lasindu-wick/Vision-Based-Ball-Balancing-PID-System-using-a-Three-DoF-Parallel-Manipulator-Mechanism/Mechanical Design/20230403_133622-removebg-preview.png

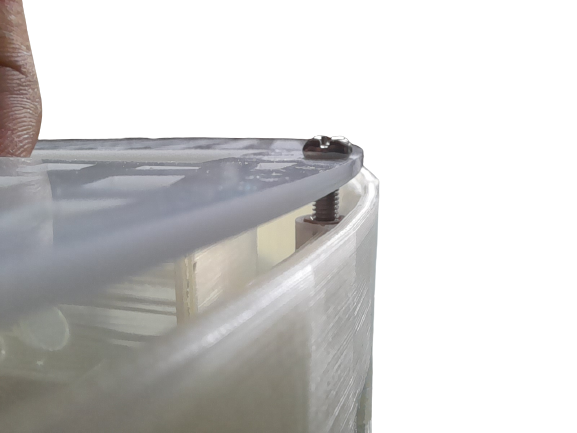
Mechanical Design/20230403_133622-removebg-preview.png
