lasindu-wick/Vision-Based-Ball-Balancing-PID-System-using-a-Three-DoF-Parallel-Manipulator-Mechanism/Mechanical Design/20230403_150713.jpg

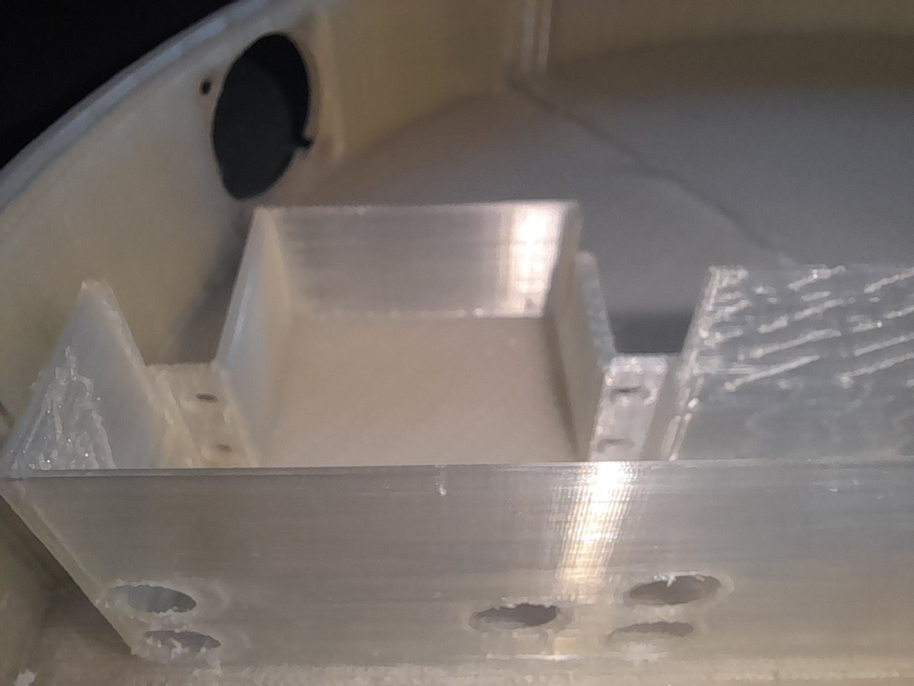
Mechanical Design/20230403_150713.jpg
