lasindu-wick/Vision-Based-Ball-Balancing-PID-System-using-a-Three-DoF-Parallel-Manipulator-Mechanism/Circuit Diagram/Circuit Diagram.jpeg

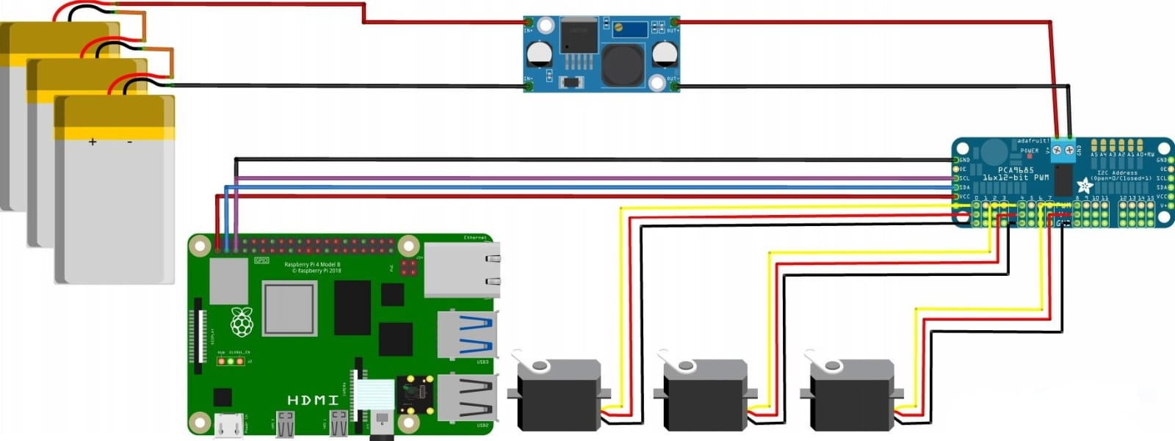
Circuit Diagram/Circuit Diagram.jpeg
