lasindu-wick/Vision-Based-Ball-Balancing-PID-System-using-a-Three-DoF-Parallel-Manipulator-Mechanism/Design Inspirations/2 DoF 2D.png

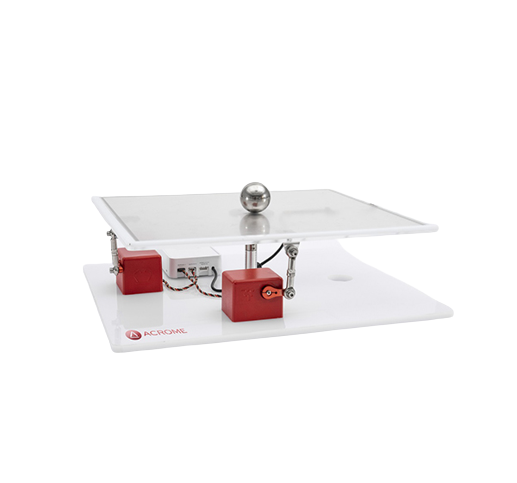
Design Inspirations/2 DoF 2D.png
