lasindu-wick/Vision-Based-Ball-Balancing-PID-System-using-a-Three-DoF-Parallel-Manipulator-Mechanism/Design Inspirations/Initial Conceptual Design.png

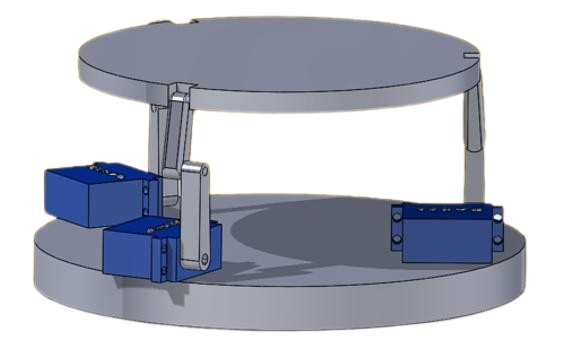
Design Inspirations/Initial Conceptual Design.png
