lasindu-wick/Vision-Based-Ball-Balancing-PID-System-using-a-Three-DoF-Parallel-Manipulator-Mechanism/Mechanical Design/10mm Spacer.png

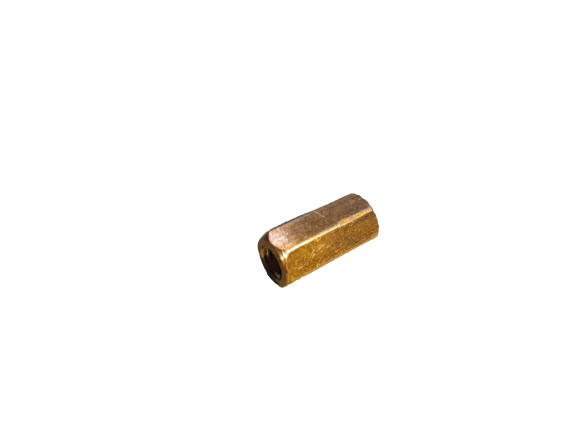
Mechanical Design/10mm Spacer.png
