lasindu-wick/Vision-Based-Ball-Balancing-PID-System-using-a-Three-DoF-Parallel-Manipulator-Mechanism/Mechanical Design/Ball & Socket Joint.png

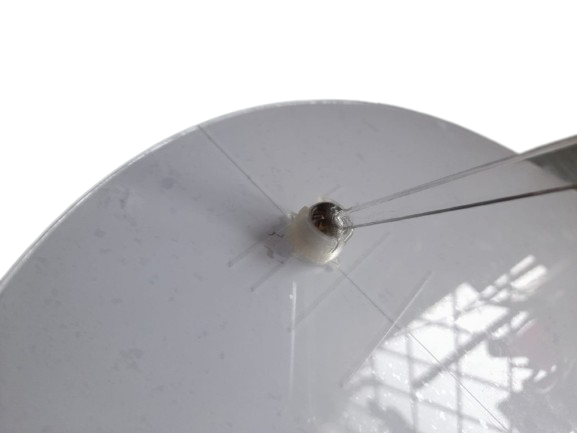
Mechanical Design/Ball & Socket Joint.png
