lasindu-wick/Vision-Based-Ball-Balancing-PID-System-using-a-Three-DoF-Parallel-Manipulator-Mechanism/Mechanical Design/Ball Balancing PID System.png

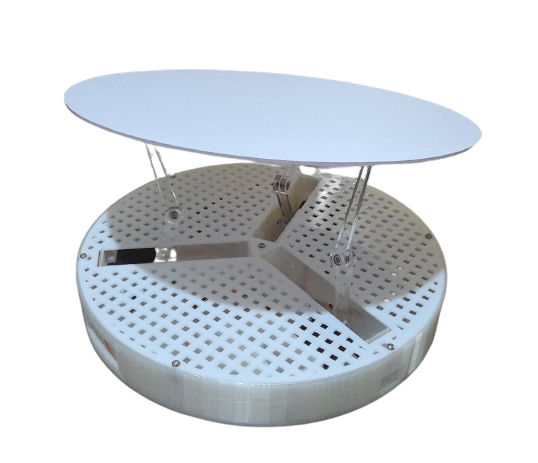
Mechanical Design/Ball Balancing PID System.png
