lasindu-wick/Vision-Based-Ball-Balancing-PID-System-using-a-Three-DoF-Parallel-Manipulator-Mechanism/Mechanical Design/Base Housing 1 FR.png

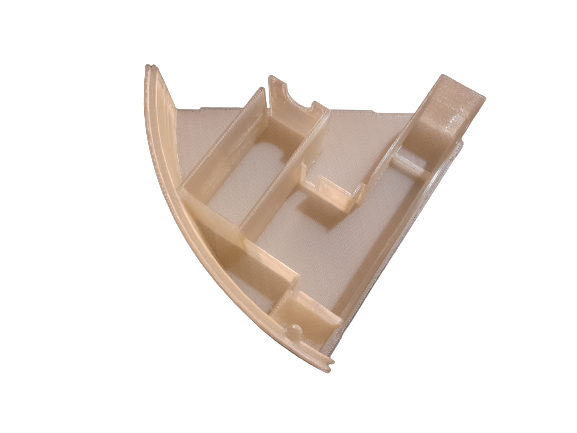
Mechanical Design/Base Housing 1 FR.png
