lasindu-wick/Vision-Based-Ball-Balancing-PID-System-using-a-Three-DoF-Parallel-Manipulator-Mechanism/Media/20230421-01.jpg

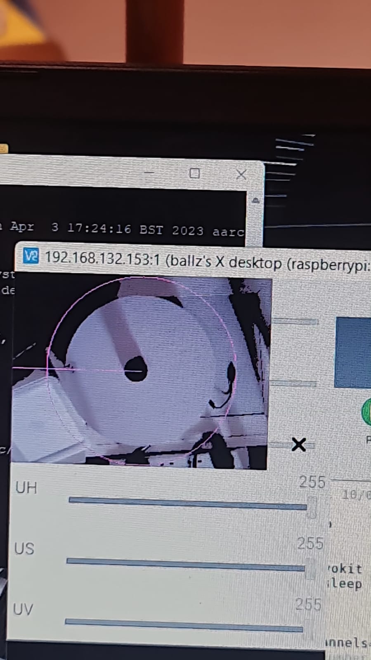
Media/20230421-01.jpg
