lasindu-wick/Vision-Based-Ball-Balancing-PID-System-using-a-Three-DoF-Parallel-Manipulator-Mechanism/Components/MG996R/MG996R.docx

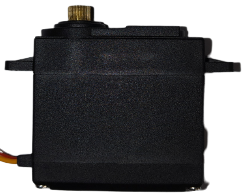
[picture p44: figure]
20230317_164744-removebg-preview
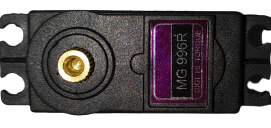
[picture p45: figure]
20230317_165555-removebg-preview
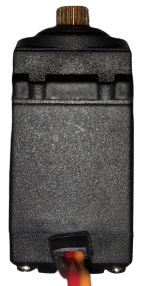
[picture p46: figure]
20230317_165631-removebg-preview

6

45

28.5

54.6

20

48.6

9.9

40.3
