lasindu-wick/Vision-Based-Ball-Balancing-PID-System-using-a-Three-DoF-Parallel-Manipulator-Mechanism/Components/3.7V 1200mAh Lipo Battery.png

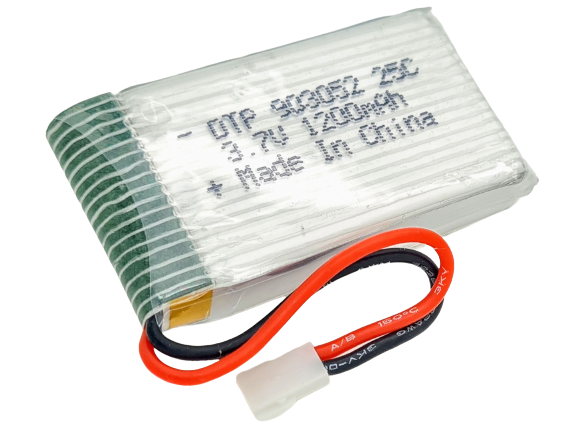
Components/3.7V 1200mAh Lipo Battery.png
