lasindu-wick/Vision-Based-Ball-Balancing-PID-System-using-a-Three-DoF-Parallel-Manipulator-Mechanism/Components/11.1V 2200mAh 3S Lipo Battery.png

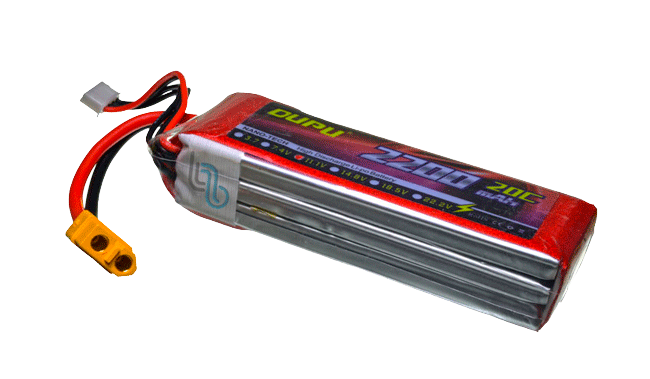
Components/11.1V 2200mAh 3S Lipo Battery.png
