lasindu-wick/Vision-Based-Ball-Balancing-PID-System-using-a-Three-DoF-Parallel-Manipulator-Mechanism/Components/693ZZ Bearing.png

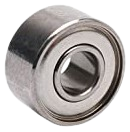
Components/693ZZ Bearing.png
