lasindu-wick/Vision-Based-Ball-Balancing-PID-System-using-a-Three-DoF-Parallel-Manipulator-Mechanism/Components/LM2596 Voltage Converter.png

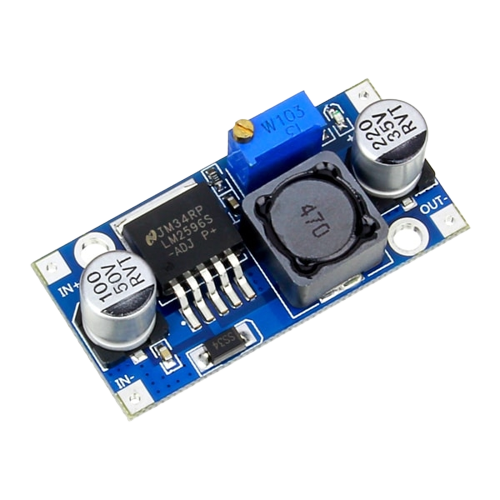
Components/LM2596 Voltage Converter.png
