lasindu-wick/Vision-Based-Ball-Balancing-PID-System-using-a-Three-DoF-Parallel-Manipulator-Mechanism/Components/Metal Casing Power Supply.jpg

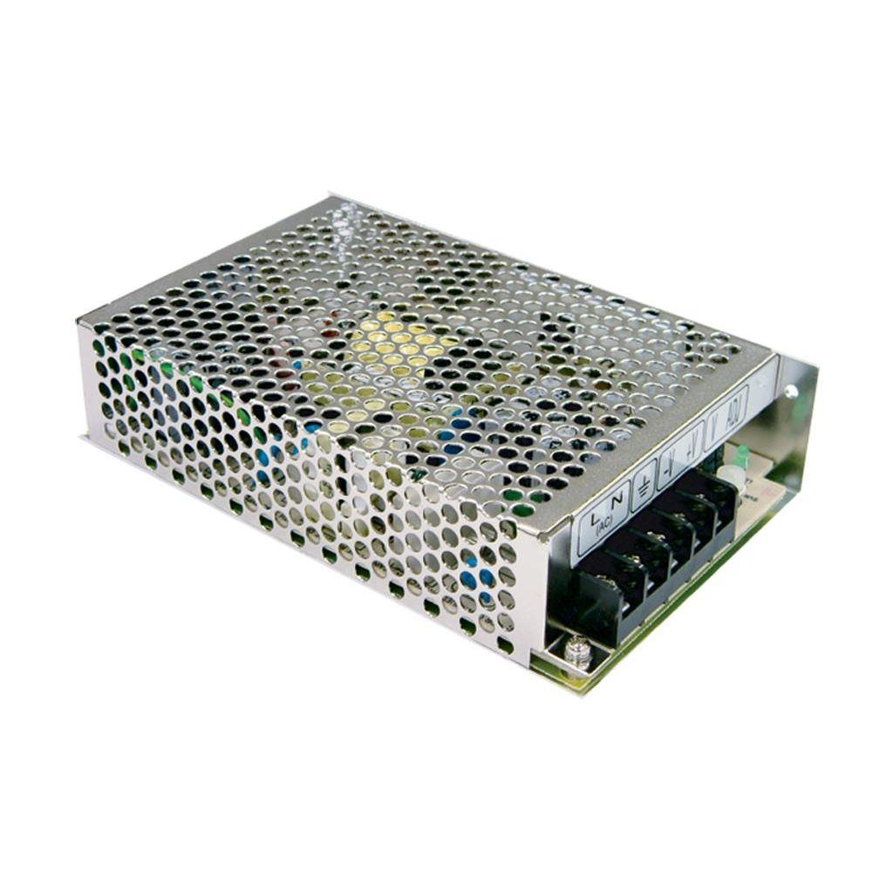
Components/Metal Casing Power Supply.jpg
