lasindu-wick/Vision-Based-Ball-Balancing-PID-System-using-a-Three-DoF-Parallel-Manipulator-Mechanism/Components/MG996R/MG996R Servo Motor.png

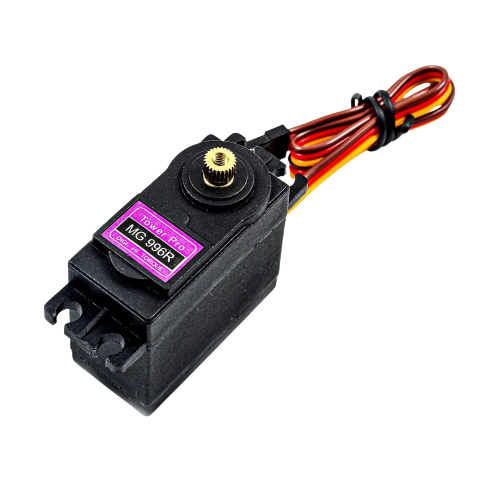
Components/MG996R/MG996R Servo Motor.png
