lasindu-wick/Vision-Based-Ball-Balancing-PID-System-using-a-Three-DoF-Parallel-Manipulator-Mechanism/Components/PCS9685 16 Channel Servo Motor Driver.png

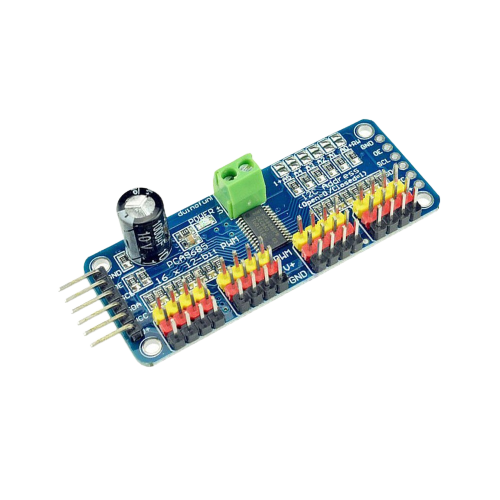
Components/PCS9685 16 Channel Servo Motor Driver.png
