lasindu-wick/Vision-Based-Ball-Balancing-PID-System-using-a-Three-DoF-Parallel-Manipulator-Mechanism/Components/RPi 4 B GPIO Pin Layout.jpg

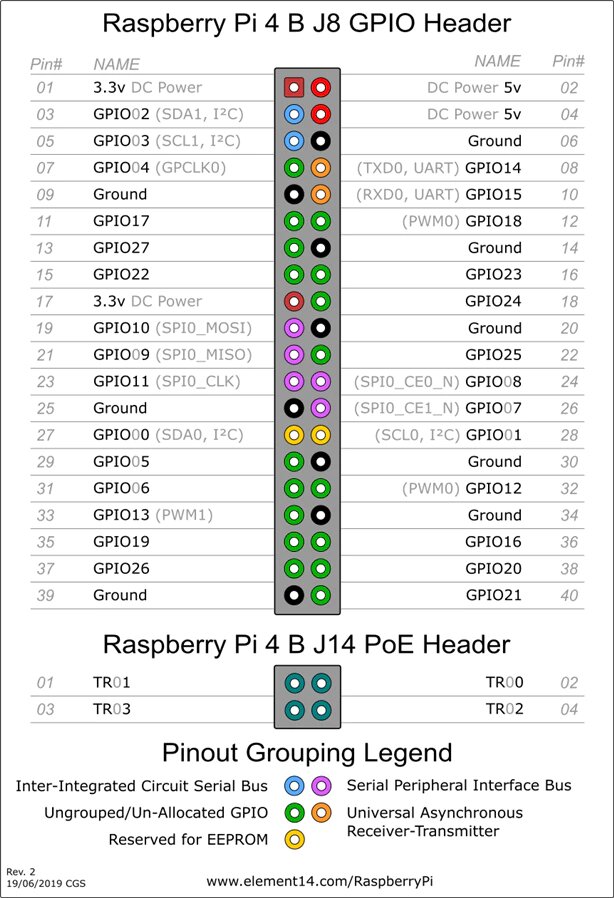
Components/RPi 4 B GPIO Pin Layout.jpg
