lasindu-wick/Vision-Based-Ball-Balancing-PID-System-using-a-Three-DoF-Parallel-Manipulator-Mechanism/Solidworks Designs/Base Housing 5.SLDPRT

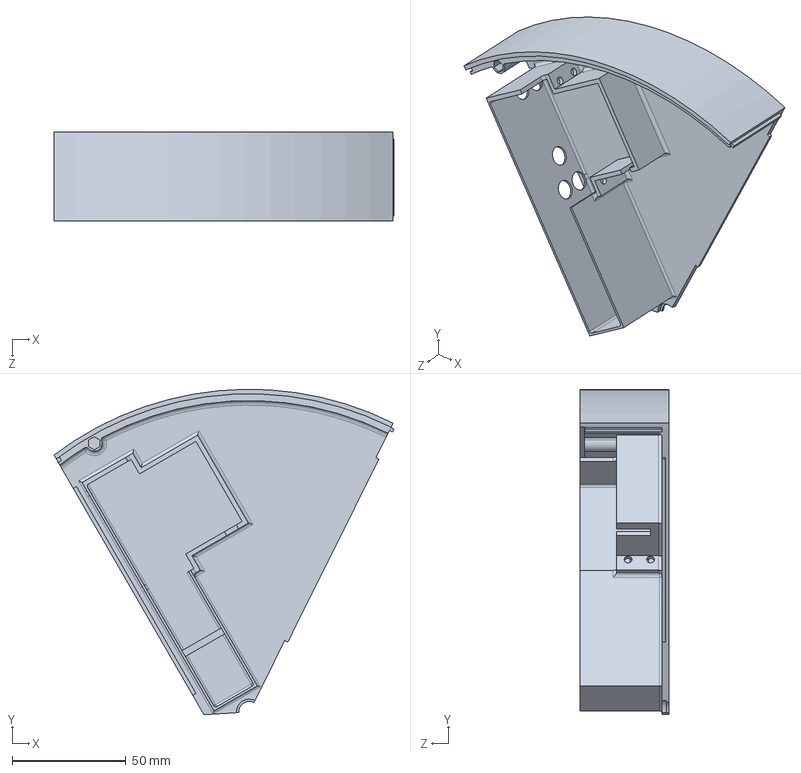
[picture p58: CAD file, 2023-07-14]
Solidworks Designs/Base Housing 5.SLDPRT
149.6 x 143.2 x 39.0 mm
