lasindu-wick/Vision-Based-Ball-Balancing-PID-System-using-a-Three-DoF-Parallel-Manipulator-Mechanism/Solidworks Designs/Base Housing 1.SLDPRT

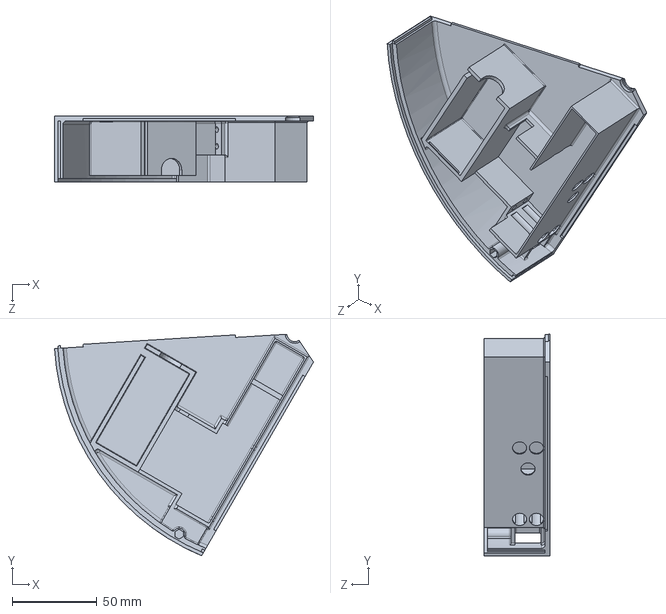
[picture p59: CAD file, 2023-07-14]
Solidworks Designs/Base Housing 1.SLDPRT
152.8 x 130.7 x 39.0 mm
