lasindu-wick/Vision-Based-Ball-Balancing-PID-System-using-a-Three-DoF-Parallel-Manipulator-Mechanism/Solidworks Designs/Base Housing 3.SLDPRT

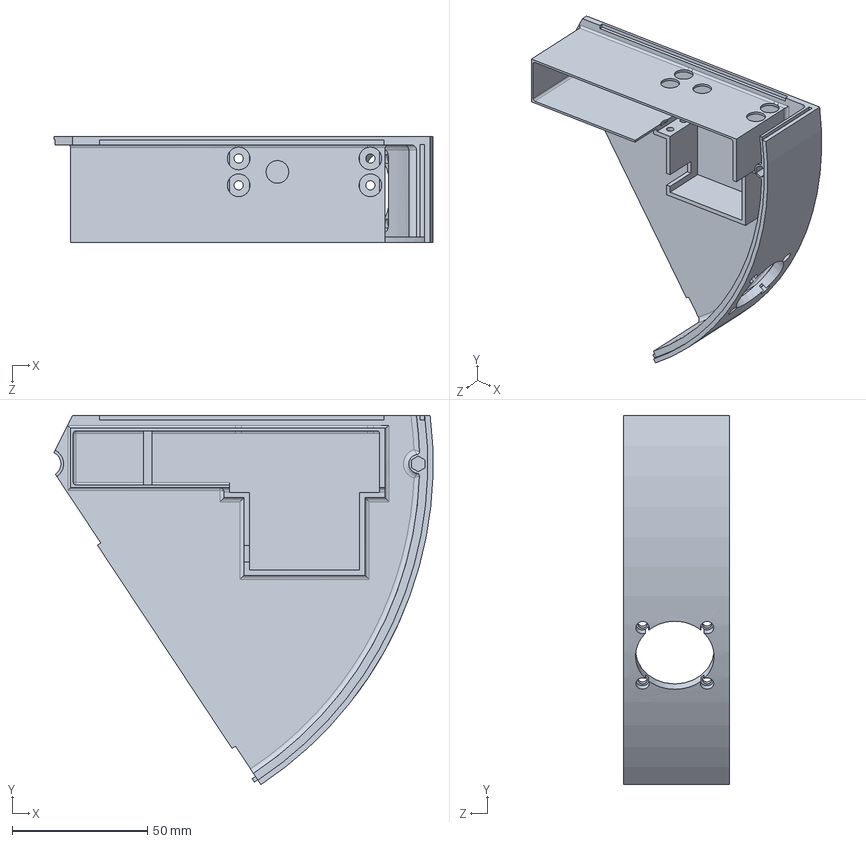
[picture p60: CAD file, 2023-07-14]
Solidworks Designs/Base Housing 3.SLDPRT
139.9 x 136.3 x 39.0 mm
