lasindu-wick/Vision-Based-Ball-Balancing-PID-System-using-a-Three-DoF-Parallel-Manipulator-Mechanism/Solidworks Designs/Socket.SLDPRT

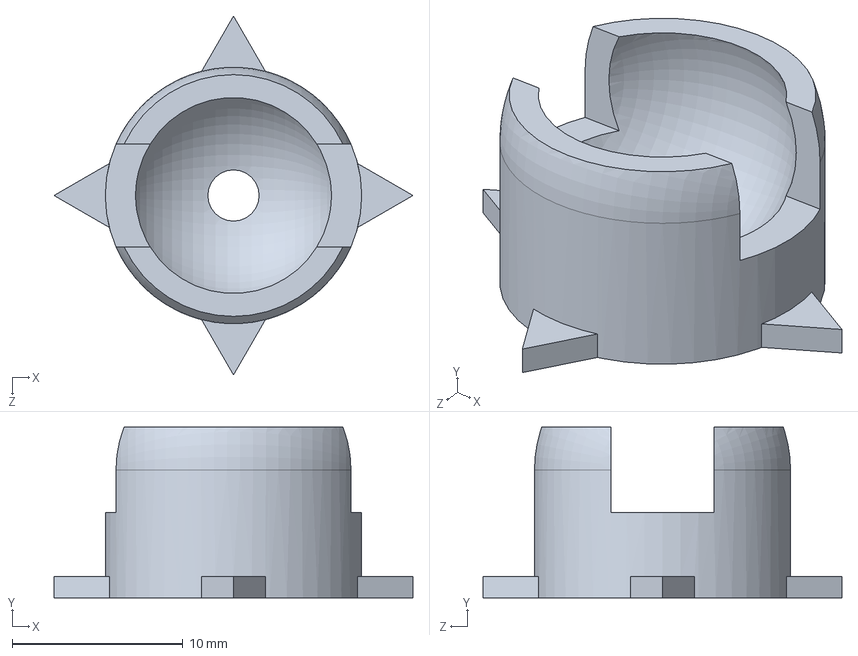
[picture p61: CAD file, 2023-07-14]
Solidworks Designs/Socket.SLDPRT
21.0 x 10.0 x 21.0 mm
