lasindu-wick/Vision-Based-Ball-Balancing-PID-System-using-a-Three-DoF-Parallel-Manipulator-Mechanism/Solidworks Designs/Spacer Housing (Test).SLDPRT

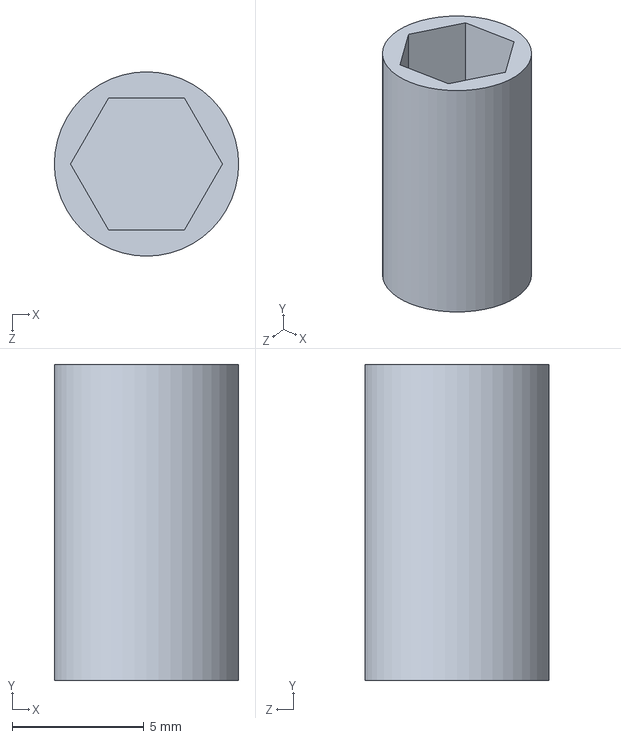
[picture p62: CAD file, 2023-07-14]
Solidworks Designs/Spacer Housing (Test).SLDPRT
7.00 x 12.0 x 7.00 mm
