lasindu-wick/Vision-Based-Ball-Balancing-PID-System-using-a-Three-DoF-Parallel-Manipulator-Mechanism/Solidworks Designs/Base Housing 6.SLDPRT

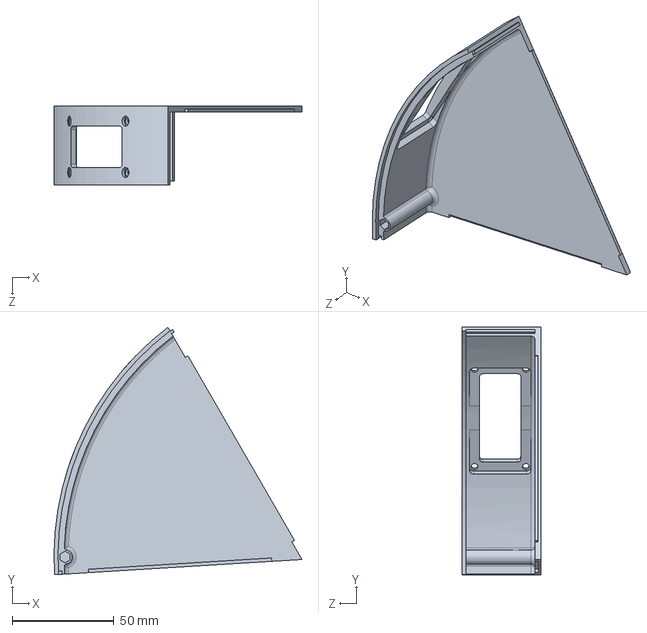
[picture p63: CAD file, 2023-07-14]
Solidworks Designs/Base Housing 6.SLDPRT
122.0 x 121.8 x 39.0 mm
