lasindu-wick/Vision-Based-Ball-Balancing-PID-System-using-a-Three-DoF-Parallel-Manipulator-Mechanism/Solidworks Designs/Base Housing.SLDPRT

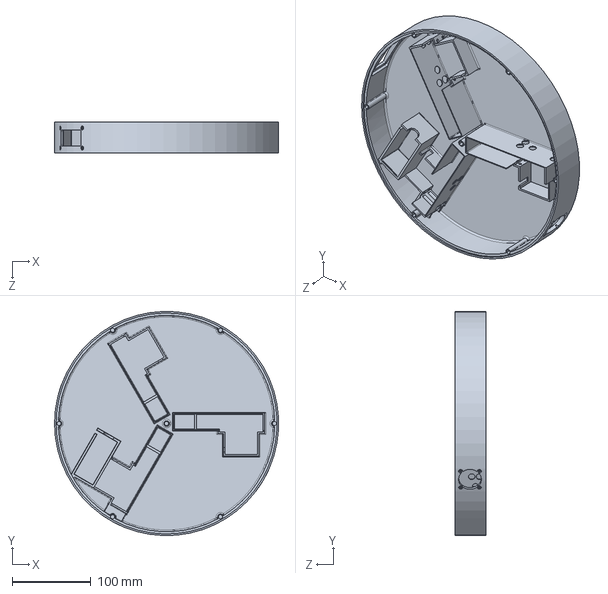
[picture p64: CAD file, 2023-07-14]
Solidworks Designs/Base Housing.SLDPRT
283.8 x 283.9 x 39.0 mm
