lasindu-wick/Vision-Based-Ball-Balancing-PID-System-using-a-Three-DoF-Parallel-Manipulator-Mechanism/Solidworks Designs/Base Housing 4.SLDPRT

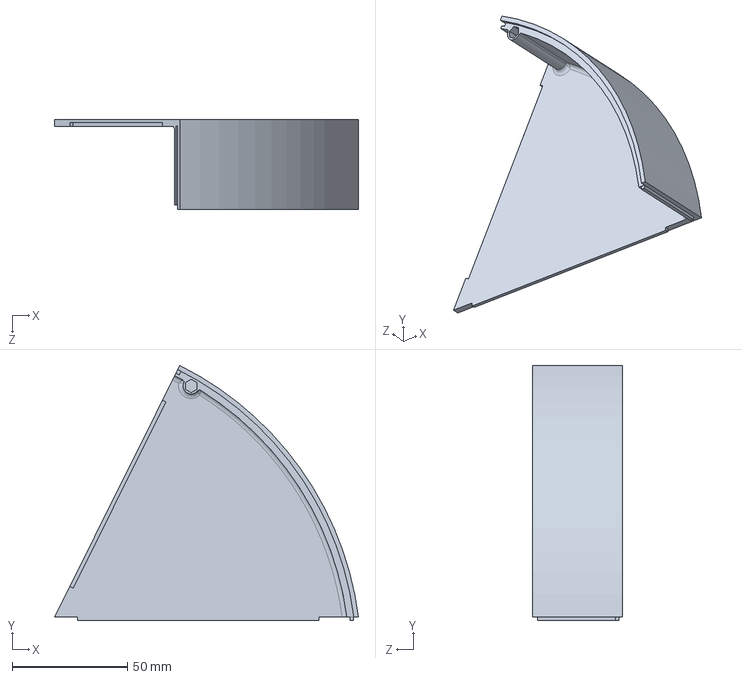
[picture p65: CAD file, 2023-07-14]
Solidworks Designs/Base Housing 4.SLDPRT
132.0 x 110.7 x 39.0 mm
