lasindu-wick/Vision-Based-Ball-Balancing-PID-System-using-a-Three-DoF-Parallel-Manipulator-Mechanism/Solidworks Designs/Base Housing 2.SLDPRT

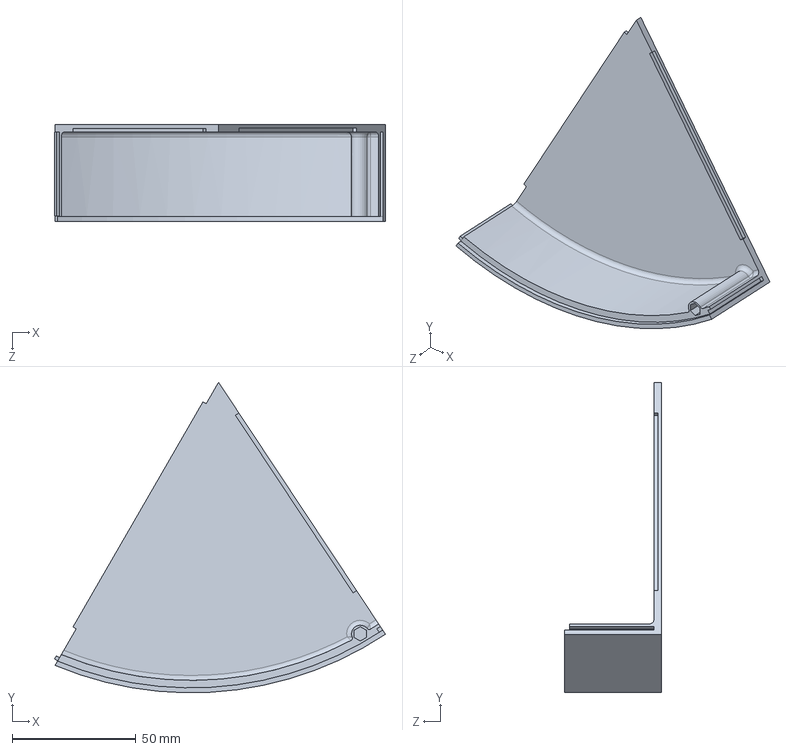
[picture p66: CAD file, 2023-07-14]
Solidworks Designs/Base Housing 2.SLDPRT
133.6 x 125.3 x 39.0 mm
