lasindu-wick/Vision-Based-Ball-Balancing-PID-System-using-a-Three-DoF-Parallel-Manipulator-Mechanism/Solidworks Designs/Servo Motor Housing (Test).SLDPRT

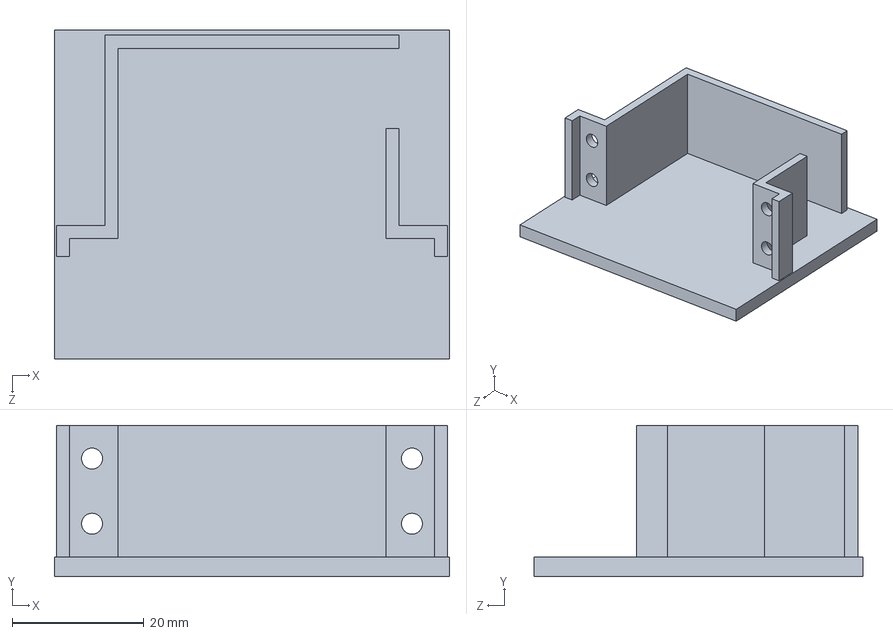
[picture p67: CAD file, 2023-07-14]
Solidworks Designs/Servo Motor Housing (Test).SLDPRT
60.0 x 23.0 x 50.0 mm
