lasindu-wick/Vision-Based-Ball-Balancing-PID-System-using-a-Three-DoF-Parallel-Manipulator-Mechanism/Solidworks Designs/Base Housing 7.SLDPRT

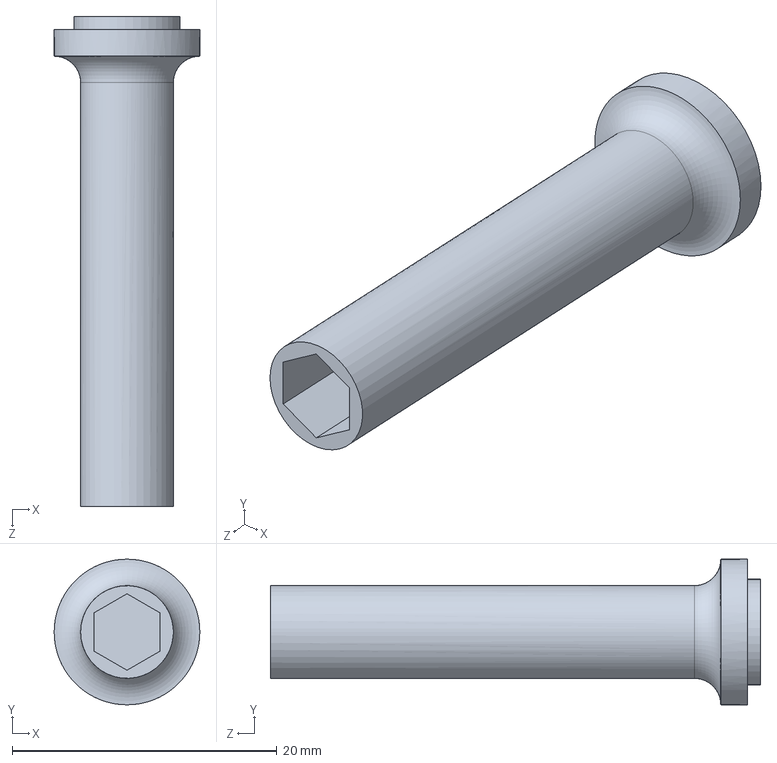
[picture p68: CAD file, 2023-07-14]
Solidworks Designs/Base Housing 7.SLDPRT
11.0 x 11.0 x 37.0 mm
