lasindu-wick/Vision-Based-Ball-Balancing-PID-System-using-a-Three-DoF-Parallel-Manipulator-Mechanism/(list of files, cad)

Other CAD files:
AutoCAD Designs/Bearing Shaft.dwg
AutoCAD Designs/Plate.dwg
AutoCAD Designs/Servo Arms.dwg
AutoCAD Designs/Geometry.dwg
AutoCAD Designs/Base Cover.dwg
Solidworks Designs/Base Housing 1.STL
Solidworks Designs/Base Housing 2.STL
Solidworks Designs/Base Housing 3.STL
Solidworks Designs/Base Housing 4.STL
Solidworks Designs/Base Housing 5.STL
Solidworks Designs/Base Housing 6.STL
Solidworks Designs/Base Housing 7.STL
Solidworks Designs/Servo Motor Housing (Test).STL
Solidworks Designs/Spacer Housing (Test).STL
