lasindu-wick/Vision-Based-Ball-Balancing-PID-System-using-a-Three-DoF-Parallel-Manipulator-Mechanism/(threads)

Thread 1 (2023-07-14):

Mechanical Issue

lasindu-wick, 2023-07-14:
There is a sideways play in the bearings that makes the joints between the two links of the Servo Arm Parallel Manipulators.
