lasindu-wick/Vision-Based-Ball-Balancing-PID-System-using-a-Three-DoF-Parallel-Manipulator-Mechanism/(list of files, drawings)

Other design files:
Circuit Diagram/Circuit Diagram.fzz
